dapadilla5986/semaforo-claude-lilygo/stl/semaforo_poste_base.stl

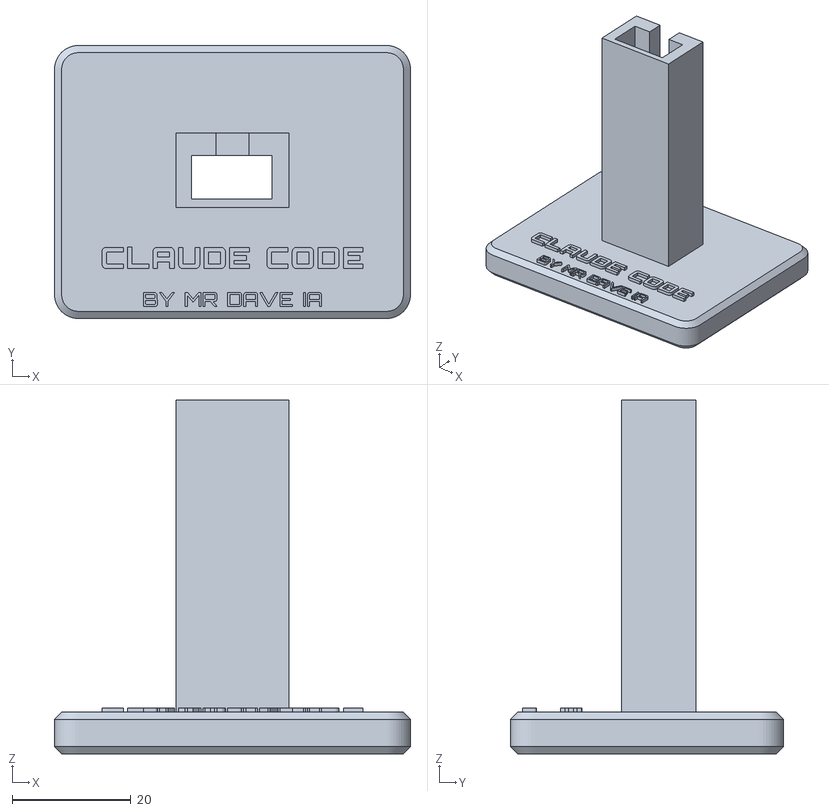
[picture p3: CAD file, 2026-11-02]
stl/semaforo_poste_base.stl
60.0 x 46.0 x 59.6
