dapadilla5986/semaforo-claude-lilygo/stl/semaforo_cuerpo_luces.stl

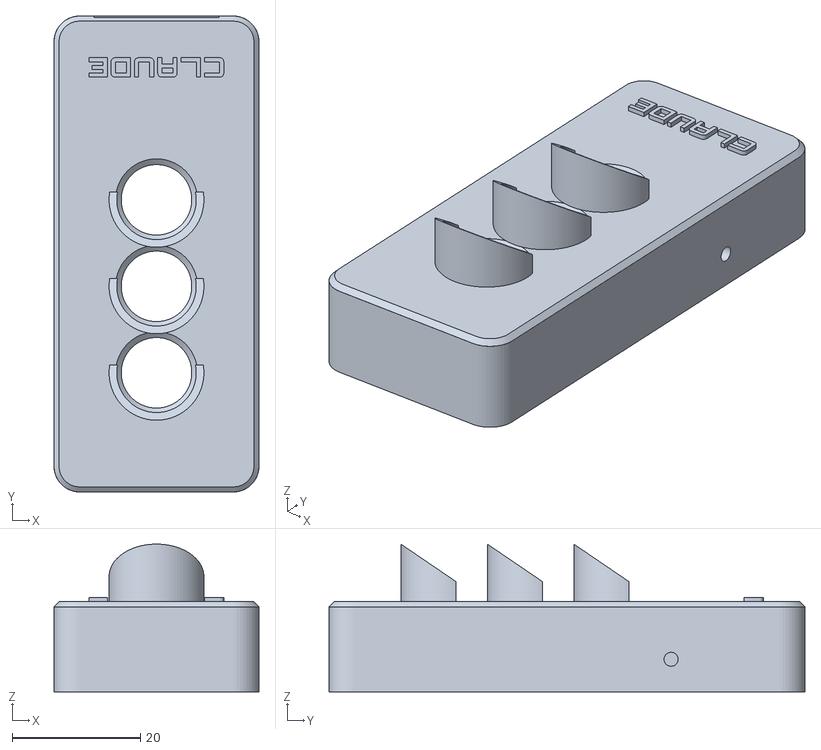
[picture p4: CAD file, 2026-11-02]
stl/semaforo_cuerpo_luces.stl
32.0 x 74.3 x 23.1
