dapadilla5986/semaforo-claude-lilygo/stl/semaforo_tapa.stl

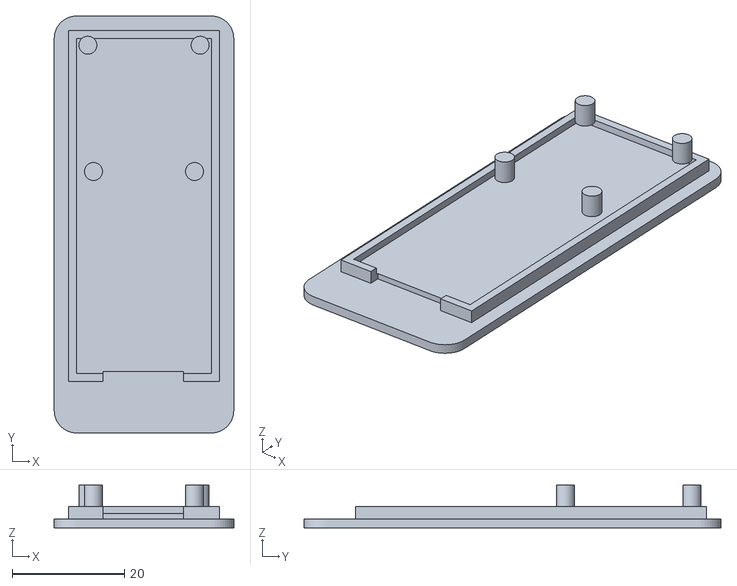
[picture p5: CAD file, 2026-11-02]
stl/semaforo_tapa.stl
32.0 x 74.3 x 7.64
