dapadilla5986/semaforo-claude-lilygo/stl/semaforo_cuerpo_ventana.stl

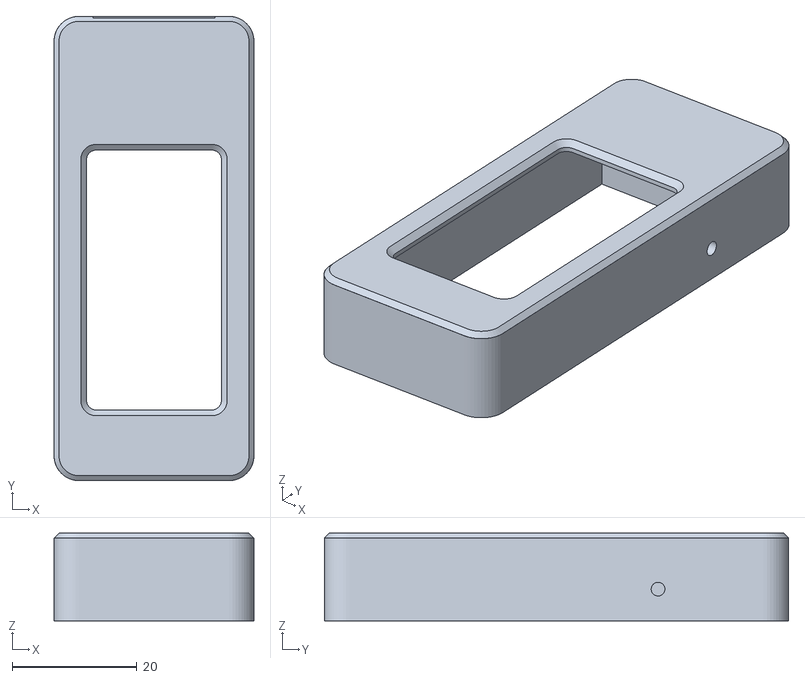
[picture p6: CAD file, 2026-11-02]
stl/semaforo_cuerpo_ventana.stl
32.0 x 74.3 x 14.1
