dapadilla5986/semaforo-claude-lilygo/(commit log)

2026-11-02 Firmware del semáforo de Claude Code para LilyGo T-Display-S3
    Por Mr Dave.
2026-11-02 Agrega las piezas 3D para imprimir y las instrucciones de montaje
    [semaforo_cuerpo_luces.stl, semaforo_cuerpo_ventana.stl, semaforo_poste_base.stl, semaforo_tapa.stl]
